ulikoehler/PowerSupplies/README.md

# PowerSupplies
Power supply PCBs &amp; documentation
