ulikoehler/PowerSupplies/LowNoiseDual5W/LowNoiseDual5W.kicad_pcb

## KiCad design LowNoiseDual5W/LowNoiseDual5W.kicad_pcb (2024-01-07)

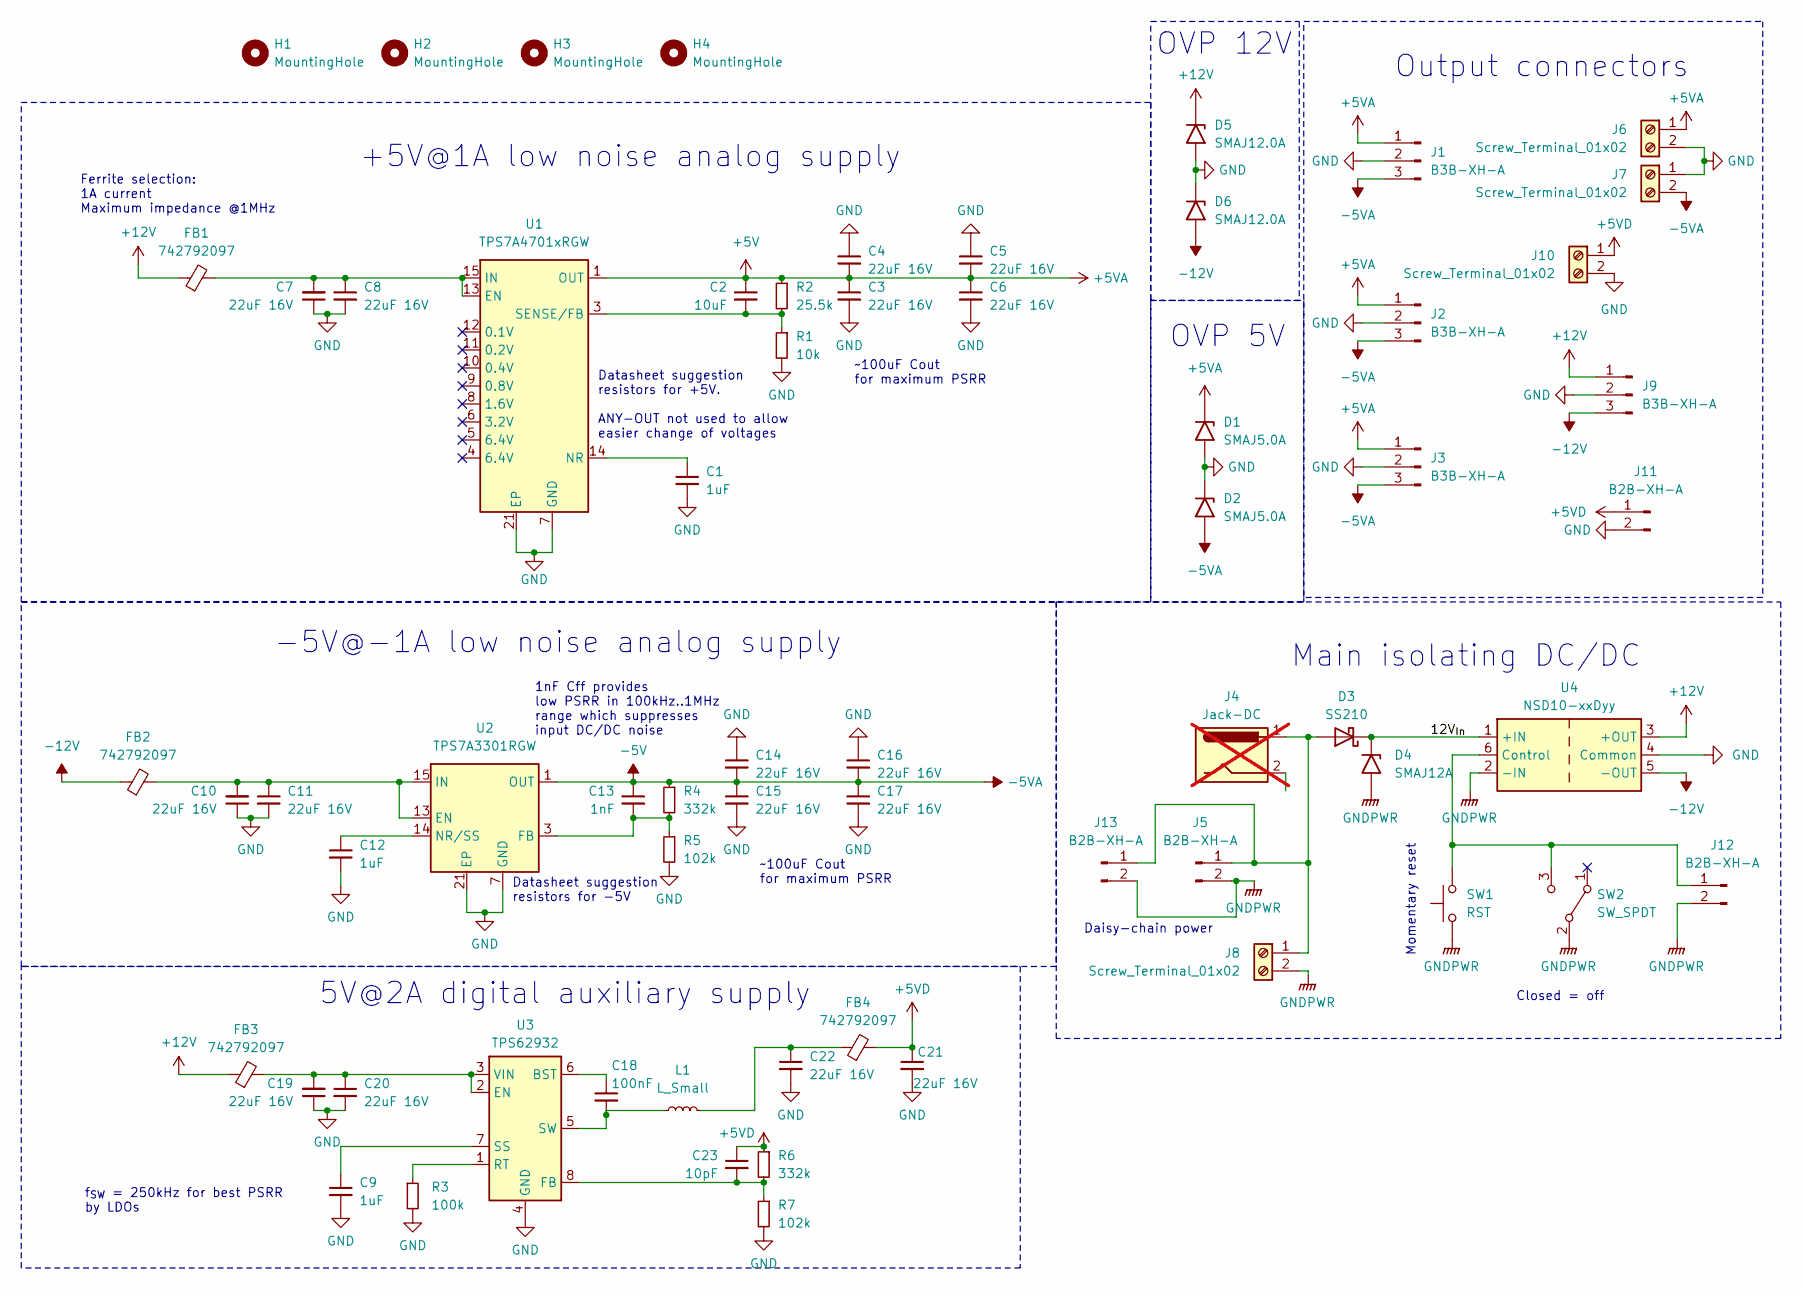
[picture p1: schematic LowNoiseDual5W.kicad_sch]

Parts:
C1, C9, C12: 1uF; R_0603_1608Metric
C2: 10uF; R_0603_1608Metric
C3, C4, C5, C6, C7, C8, C10, C11, C14, C15, C16, C17, C19, C20, C21, C22: 22uF 16V; C_1206_3216Metric; MPN CL31A226MOCLNNC
C13: 1nF; R_0603_1608Metric
C18: 100nF; R_0603_1608Metric
C23: 10pF; R_0603_1608Metric
D1, D2: SMAJ5.0A; D_SMA
D3: SS210; D_SMA
D4: SMAJ12A; D_SMA
D5, D6: SMAJ12.0A; D_SMA
FB1, FB2, FB3, FB4: 742792097; L_0805_2012Metric
H1, H2, H3, H4: MountingHole; MountingHole_3.2mm_M3_ISO7380
J1, J2, J3, J9: B3B-XH-A; JST_XH_B3B-XH-A_1x03_P2.50mm_Vertical
J4: Jack-DC; BarrelJack_GCT_DCJ200-10-A_Horizontal; not fitted
J5, J11, J13: B2B-XH-A; JST_XH_B2B-XH-A_1x02_P2.50mm_Vertical
J6, J7, J8, J10: Screw_Terminal_01x02; TerminalBlock_Phoenix_MKDS-1,5-2-5.08_1x02_P5.08mm_Horizont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
J12: B2B-XH-A; JST_PH_B2B-PH-K_1x02_P2.00mm_Vertical
L1: L_Small; L_SXN_SMDRI127
R1: 10k; R_0603_1608Metric
R2: 25.5k; R_0603_1608Metric
R3: 100k; R_0603_1608Metric
R4, R6: 332k; R_0603_1608Metric
R5, R7: 102k; R_0603_1608Metric
SW1: RST; SW_SPST_TL3342; MPN TC-0522C-1.6-160G; LCSC Part # C2845287
SW2: SW_SPDT; SW_DPDT_CK_JS202011JCQN
U1: TPS7A4701xRGW; Texas_S-PVQFN-N20_EP3.15x3.15mm
U2: TPS7A3301RGW; Texas_S-PVQFN-N20_EP3.15x3.15mm
U3: TPS62932; SOT-583-8
U4: NSD10-xxDyy; Converter_DCDC_MeanWell_NSD10_THT

Connections:
+5V: C2.1, C3.1, C4.2, C5.2, C6.1, D1.1 (A1), J1.1, J2.1, J3.1, J6.1, R2.1, U1.1 (OUT), U1.20 (OUT)
+5VD: C21.1, C23.1, FB4.2, J10.1, J11.1, R6.1
+12V: D5.1 (A1), FB1.1, FB3.1, J9.1, U4.3 (+OUT)
-5V: C13.1, C14.2, C15.1, C16.2, C17.1, D2.2 (A2), J1.3, J2.3, J3.3, J7.2, R4.1, U2.1 (OUT), U2.20 (OUT)
-12V: D6.2 (A2), FB2.1, J9.3, U4.5 (-OUT)
/12V_{In}: D3.1 (K), D4.1 (A1), U4.1 (+IN)
GND: C1.2, C3.2, C4.1, C5.1, C6.2, C7.1, C8.2, C9.2, C10.1, C11.2, C12.2, C14.1, C15.2, C16.1, C17.2, C19.1, C20.2, C21.2, C22.2, D1.2 (A2), D2.1 (A1), D5.2 (A2), D6.1 (A1), J1.2, J2.2, J3.2, J6.2, J7.1, J9.2, J10.2, J11.2, R1.2, R3.2, R5.2, R7.2, U1.7 (GND), U1.21 (EP), U2.7 (GND), U2.21 (EP), U3.4 (GND), U4.4 (Common)
GNDPWR: D4.2 (A2), J5.2, J8.2, J12.2, J13.2, SW1.2, SW2.2 (B), U4.2 (-IN)
IN: C10.2, C11.1, FB2.2, U2.13 (EN), U2.15 (IN), U2.16 (IN)
unnamed: C22.1, FB4.1, L1.2
unnamed: D3.2 (A), J4.1, J5.1, J8.1, J13.1
unnamed: J12.1, SW1.1, SW2.3 (C), U4.6 (Control)
unnamed: C7.2, C8.1, FB1.2, U1.13 (EN), U1.15 (IN), U1.16 (IN)
unnamed: C1.1, U1.14 (NR)
unnamed: C2.2, R1.1, R2.2, U1.3 (SENSE/FB)
unnamed: C13.2, R4.2, R5.1, U2.3 (FB)
unnamed: C12.1, U2.14 (NR/SS)
unnamed: C18.1, U3.6 (BST)
unnamed: C19.2, C20.1, FB3.2, U3.2 (EN), U3.3 (VIN)
unnamed: C23.2, R6.2, R7.1, U3.8 (FB)
unnamed: R3.1, U3.1 (RT)
unnamed: C9.1, U3.7 (SS)
unnamed: C18.2, L1.1, U3.5 (SW)

Notes on the sheet:
OVP 12V
-5V@-1A low noise analog supply
f_{SW} = 250kHz for best PSRR by LDOs
~100uF Cout for maximum PSRR
Closed = off
1nF Cff provides low PSRR in 100kHz..1MHz range which suppresses input DC/DC noise
+5V@1A low noise analog supply
Momentary reset
Main isolating DC/DC
Datasheet suggestion resistors for +5V. ANY-OUT not used to allow easier change of voltages
Ferrite selection: 1A current Maximum impedance @1MHz
Daisy-chain power
OVP 5V
5V@2A digital auxiliary supply
Datasheet suggestion resistors for -5V
Output connectors

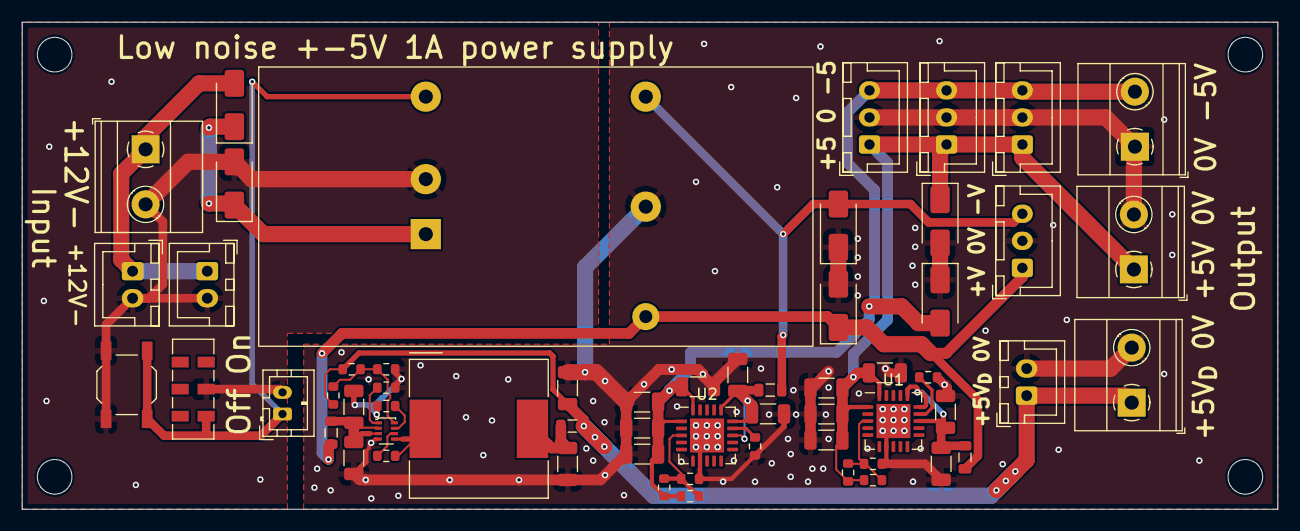
[picture p2: board LowNoiseDual5W.kicad_pcb from above]

Board: 2 copper layers, 116.0 x 45.0 mm, 63 parts (0 on the bottom side), 23 nets.
