ulikoehler/PowerSupplies/(commit log)

2024-01-04 Initialize low noise dual 5W project
    [LowNoiseDual5W.kicad_pcb, LowNoiseDual5W.kicad_sch]
2024-01-07 Implement low noise dual 5W power supply
    [LowNoiseDual5W.kicad_pcb, LowNoiseDual5W.kicad_sch]
